FPiorski/XYGen/README.md

# XYgen
### 4 digit numerical diplay using an oscilloscope in XY mode without a microcontroller

#### Work in progress
Soldered everything up, found some bugs, still working on getting them all fixed
