FPiorski/XYGen/XYgen.pdf

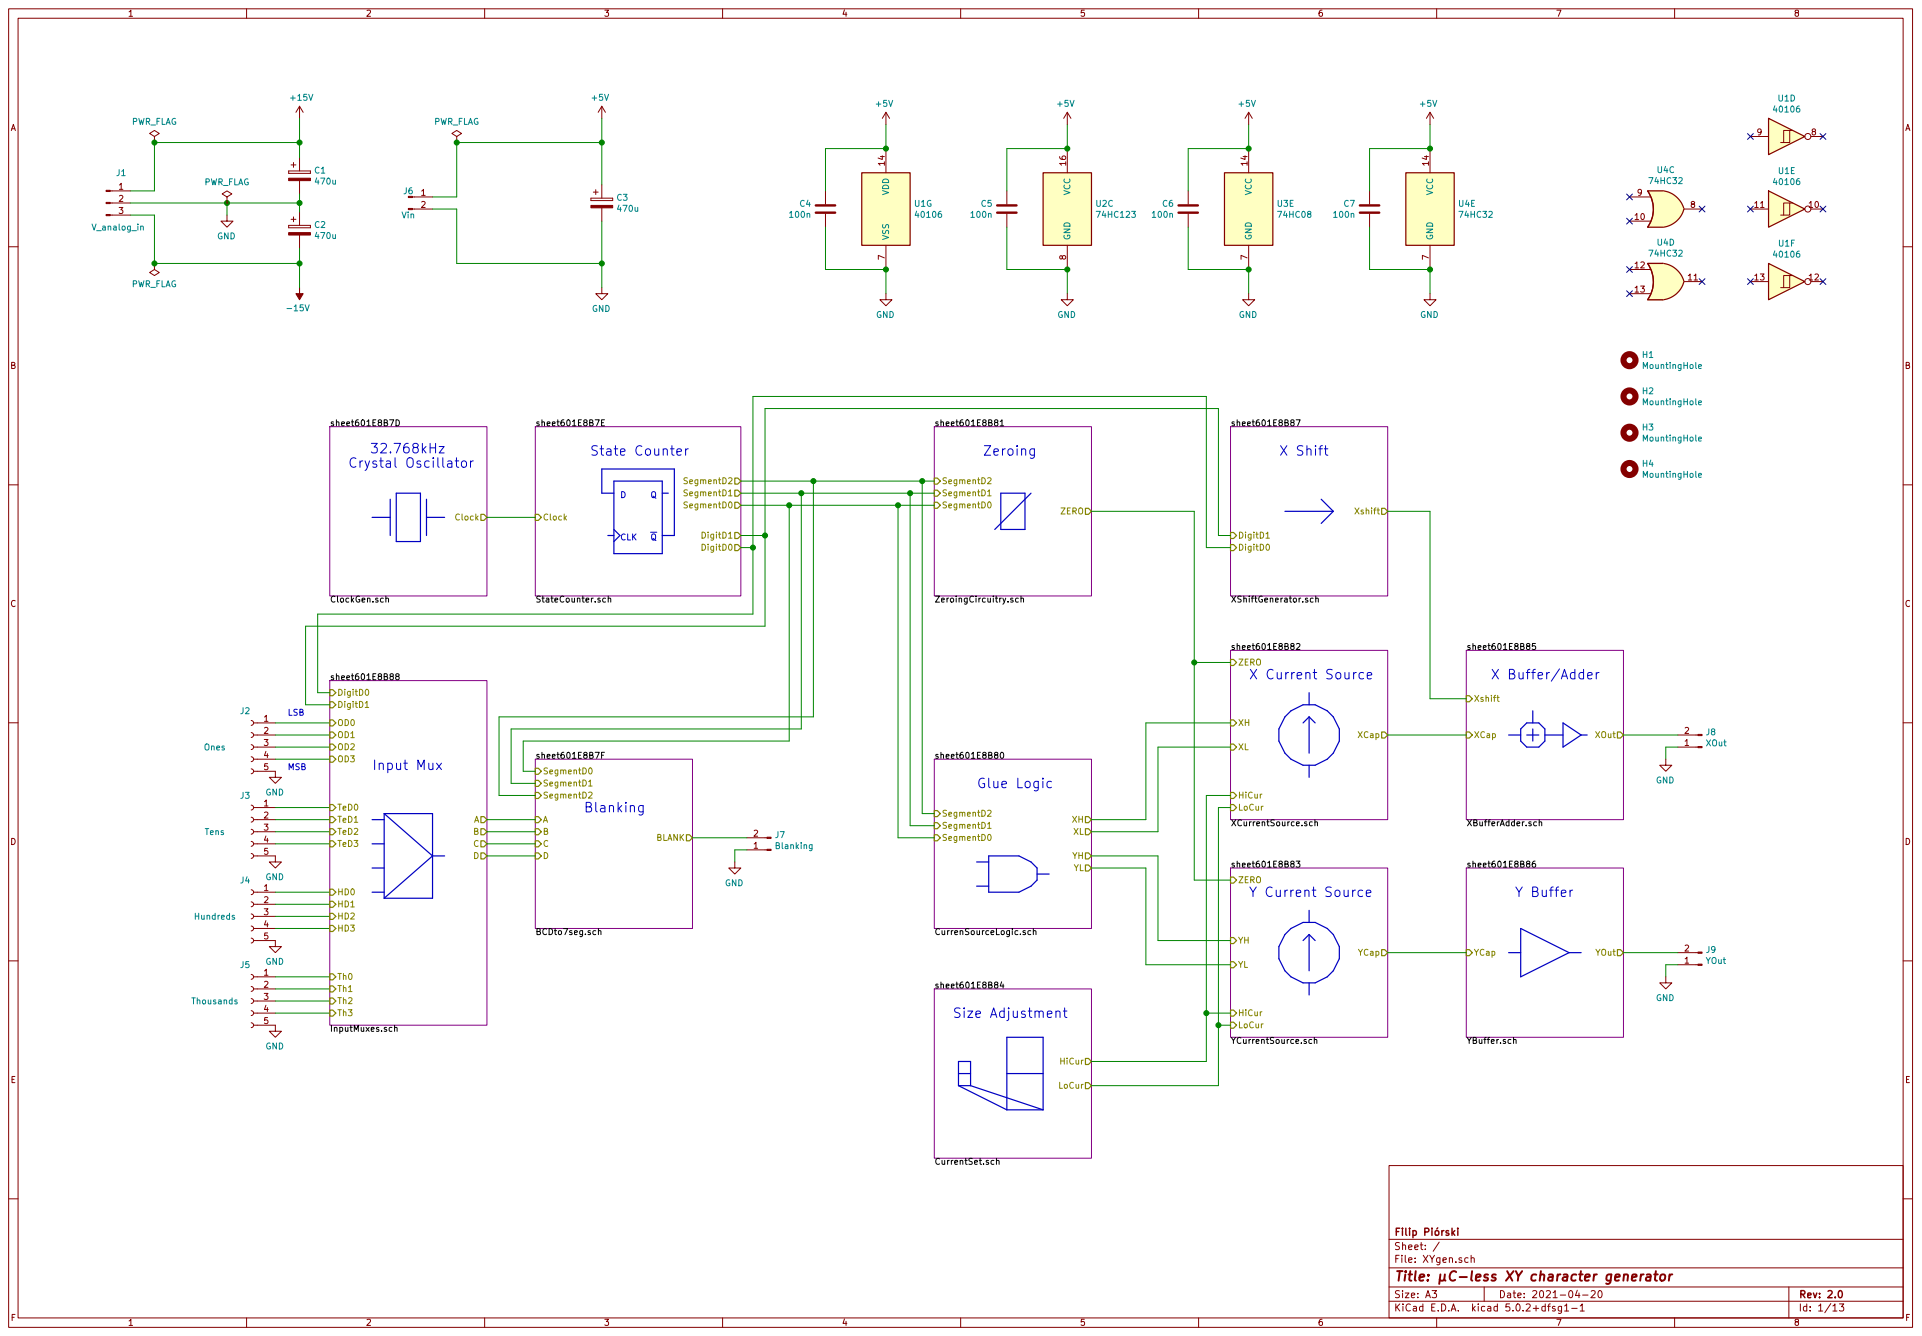
[picture p1: page 1]

File: XYgen.sch Sheet: / Filip Piórski

Id: 1/13 Title: µC-less XY character generator

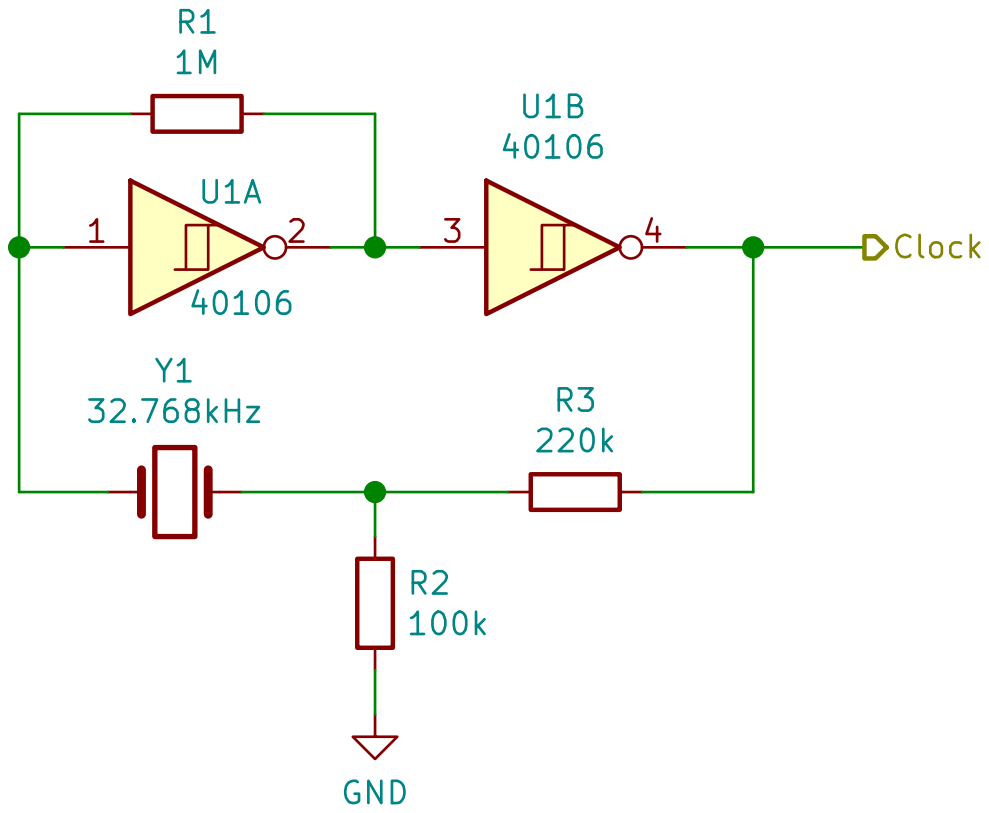
[picture p2: page 2]

Id: 2/13 Title: 32.786kHz Quartz Clock Generator File: ClockGen.sch Sheet: /sheet601E8B7D/ Filip Piórski

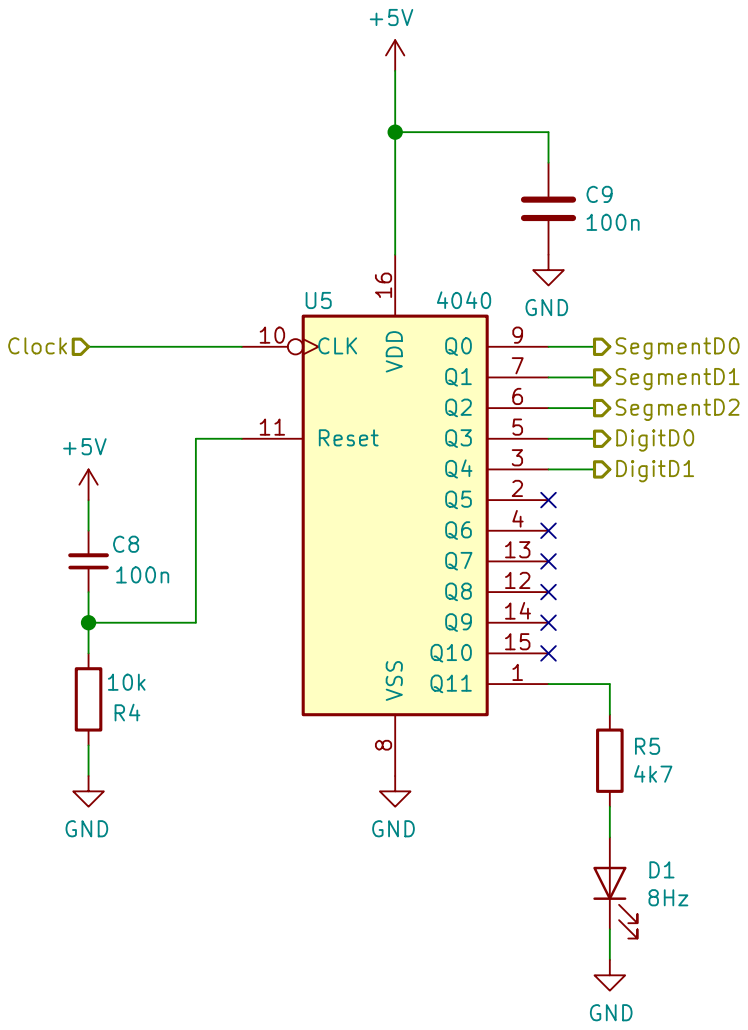
[picture p3: page 3]

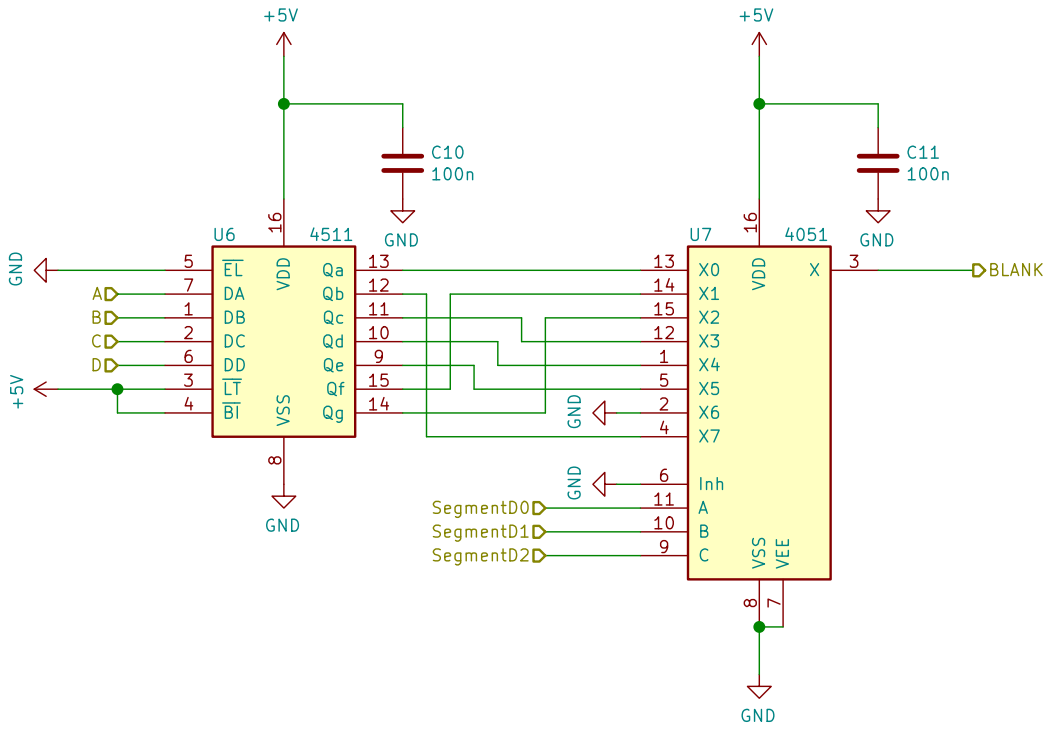
[picture p4: page 4]

Id: 4/13 Title: Blanking Signal Generator

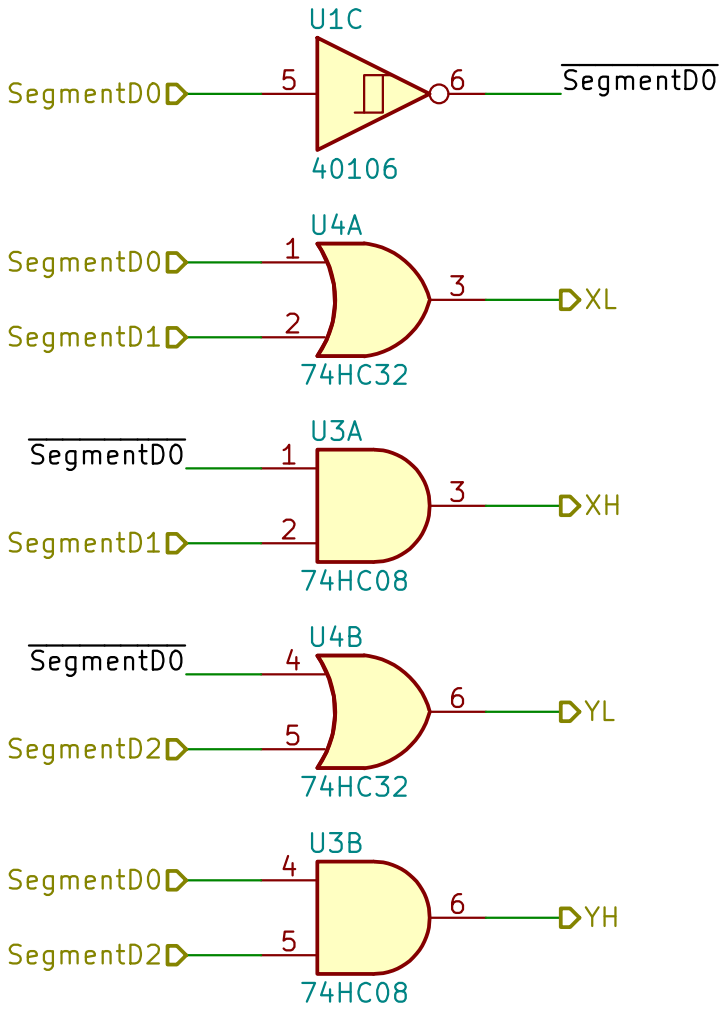
[picture p5: page 5]

File: CurrenSourceLogic.sch Sheet: /sheet601E8B80/ Filip Piórski

Id: 5/13 Title: Current Source Control Signal Generator

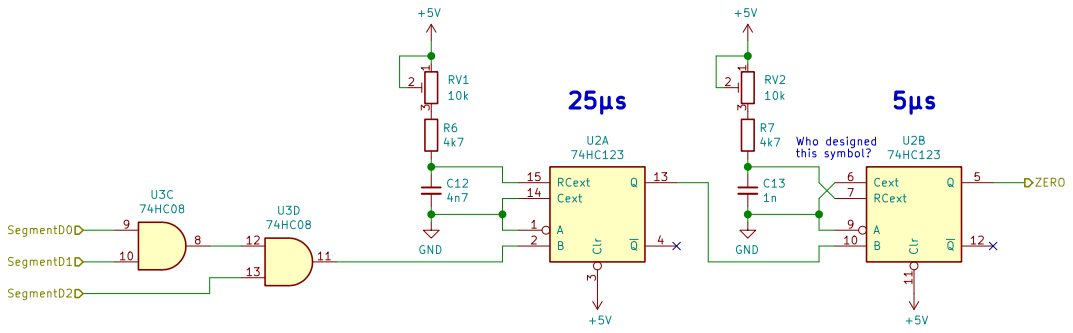
[picture p6: page 6]

File: ZeroingCircuitry.sch Sheet: /sheet601E8B81/ Filip Piórski A

Id: 6/13 Title: Zero Signal Generator

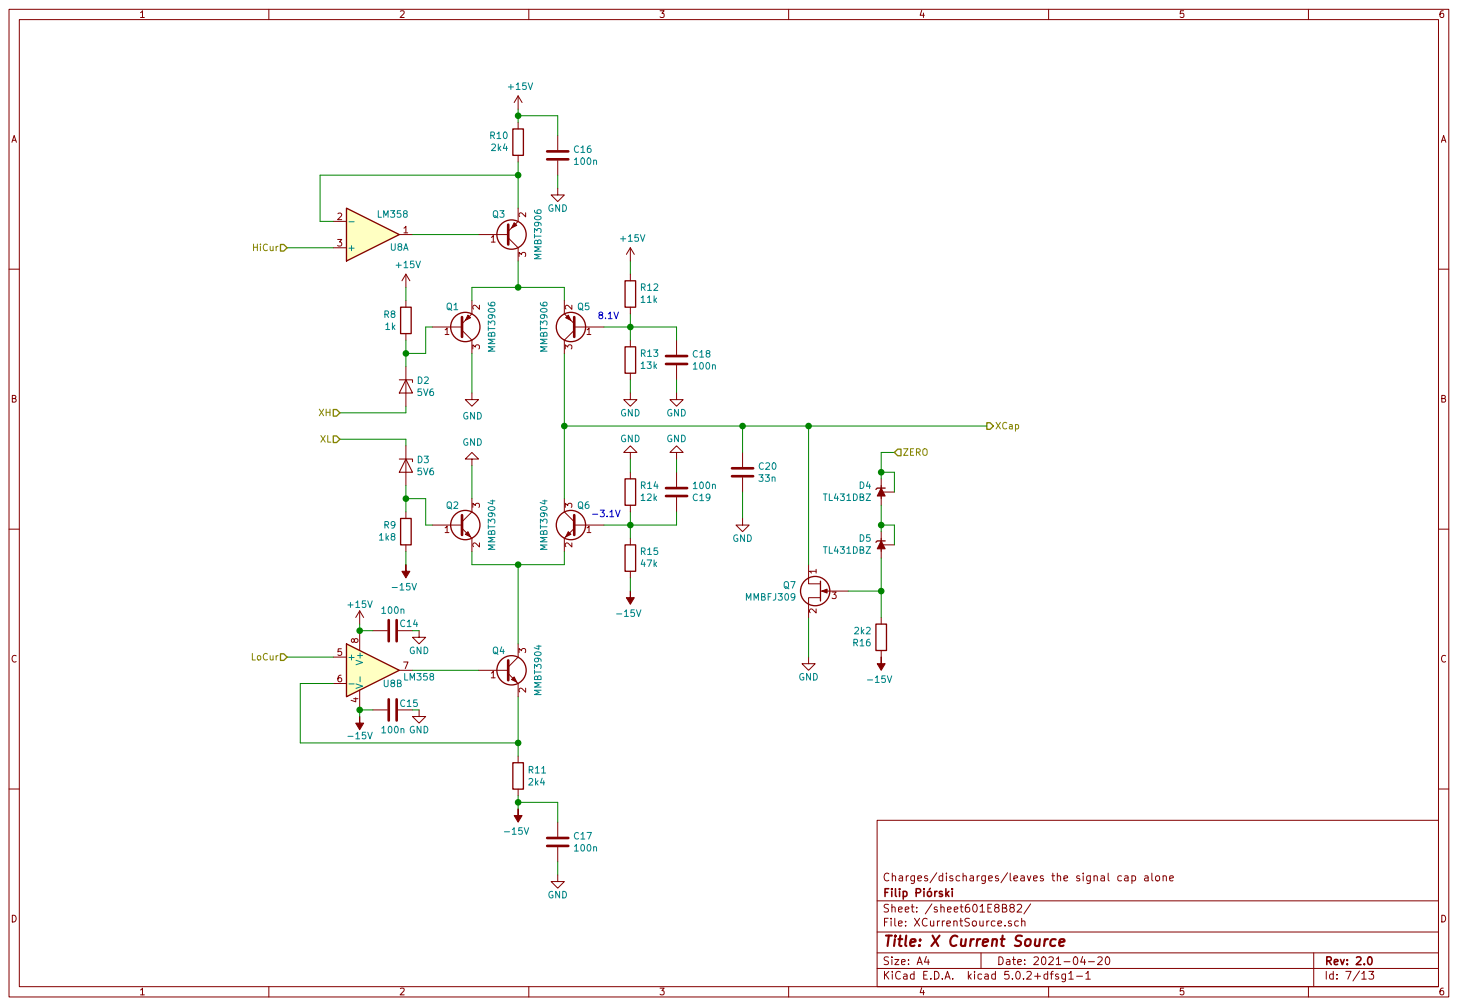
[picture p7: page 7]

File: XCurrentSource.sch Sheet: /sheet601E8B82/ Filip Piórski

Id: 7/13 Title: X Current Source

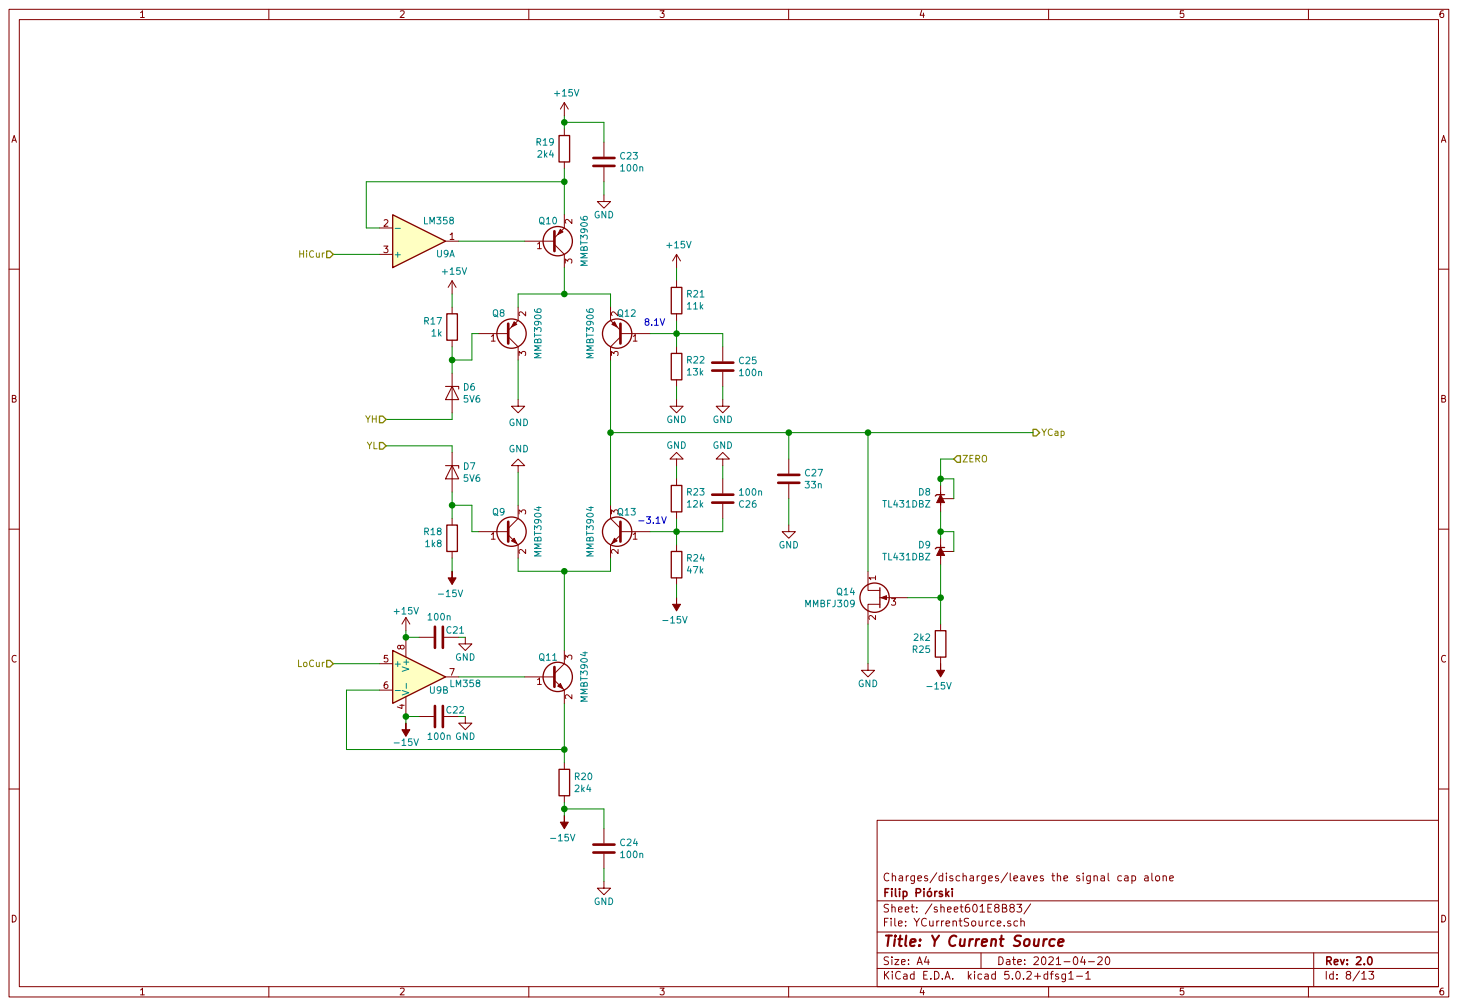
[picture p8: page 8]

File: YCurrentSource.sch Sheet: /sheet601E8B83/ Filip Piórski

Id: 8/13 Title: Y Current Source

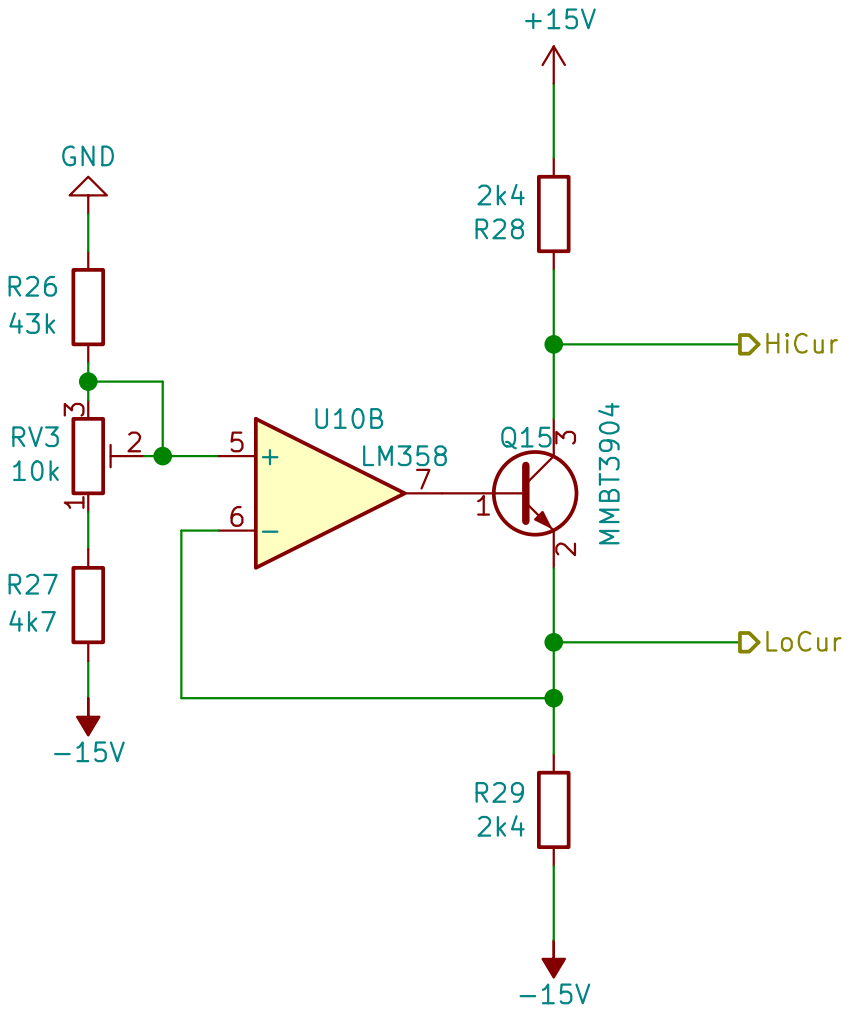
[picture p9: page 9]

Id: 9/13 Title: Size Adjustment File: CurrentSet.sch Sheet: /sheet601E8B84/ Filip Piórski 1

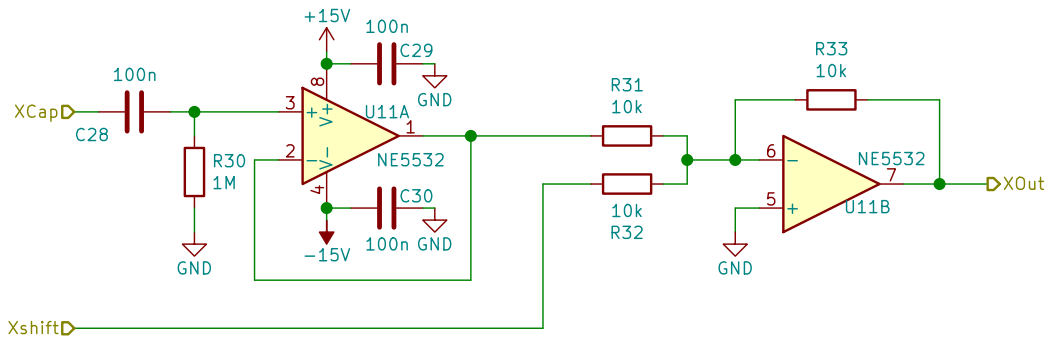
[picture p10: page 10]

Buffers the X signal and adds an offset (shift)
Id: 10/13 Title: X Buffer/Adder File: XBufferAdder.sch Sheet: /sheet601E8B85/ Filip Piórski

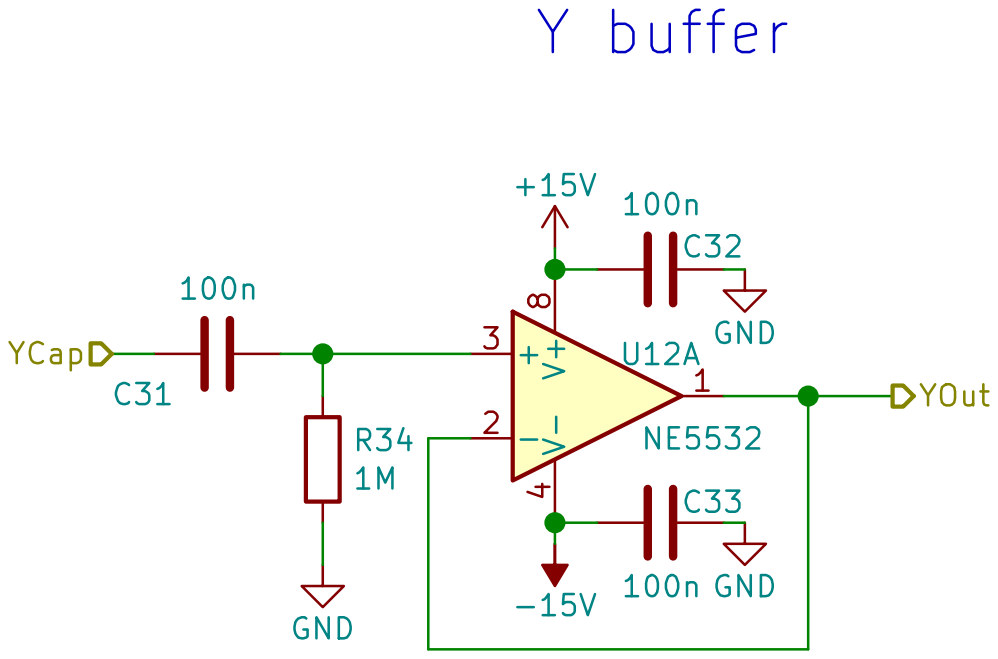
[picture p11: page 11]

Id: 11/13 Title: Y Buffer File: YBuffer.sch Sheet: /sheet601E8B86/ Filip Piórski

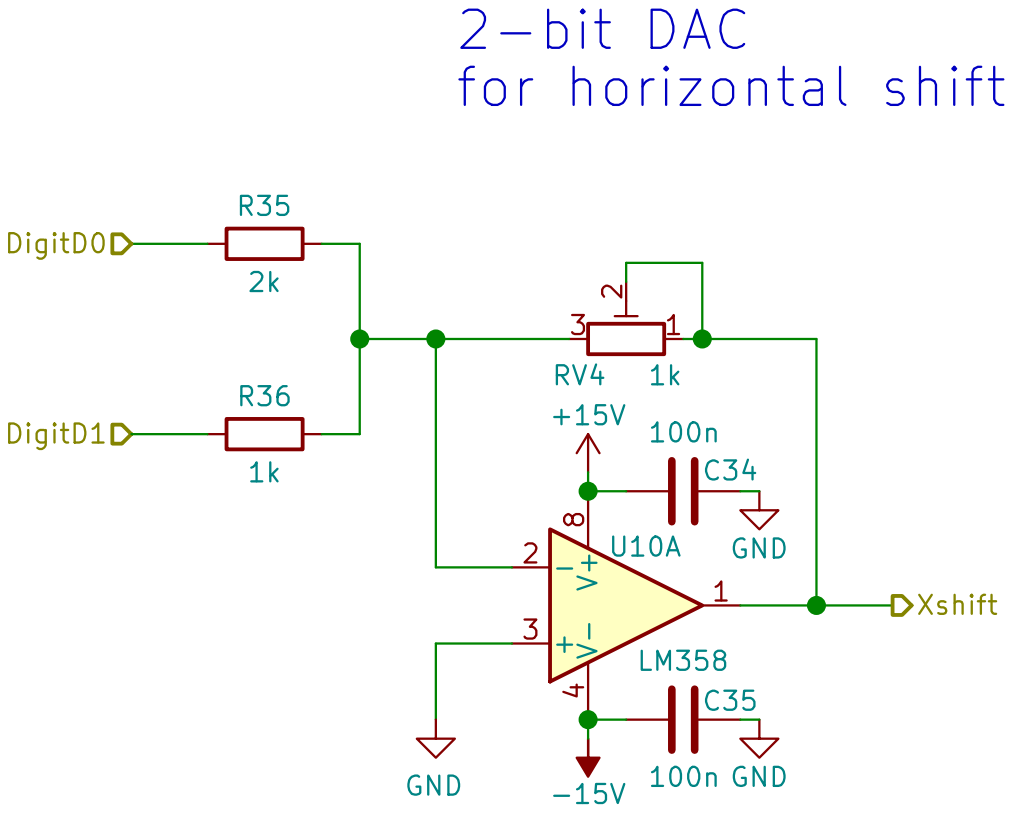
[picture p12: page 12]

Id: 12/13 Title: Horiznontal Shift Generator File: XShiftGenerator.sch Sheet: /sheet601E8B87/ Filip Piórski

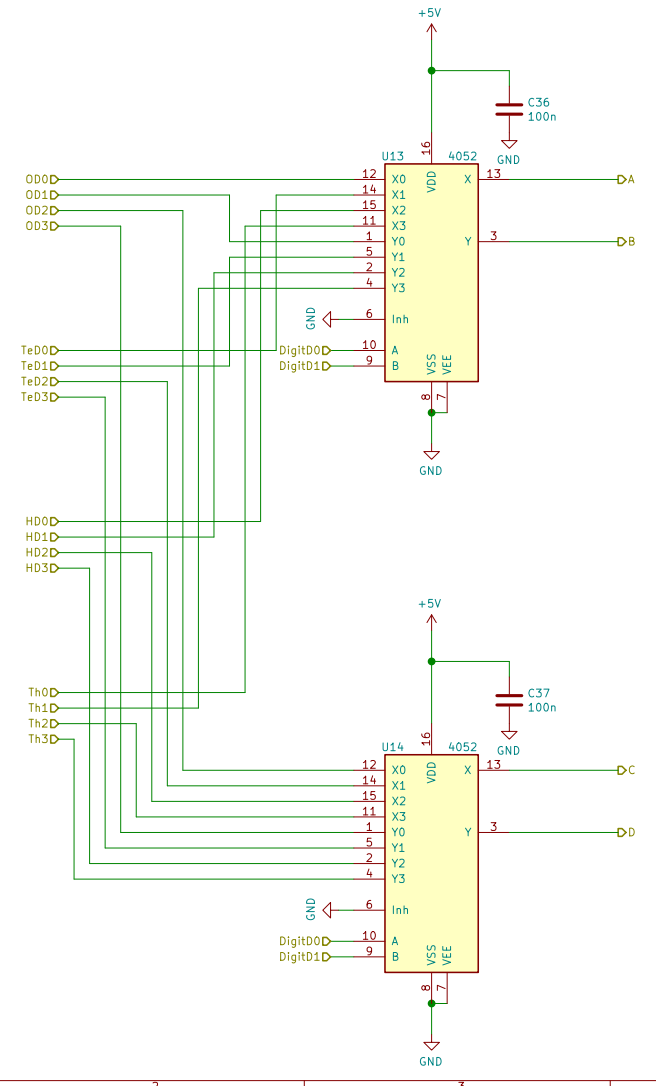
[picture p13: page 13]

Id: 13/13 Title: Input Multiplexer
