FPiorski/XYGen/XYgen.kicad_pcb

## KiCad design XYgen.kicad_pcb (2021-04-20)

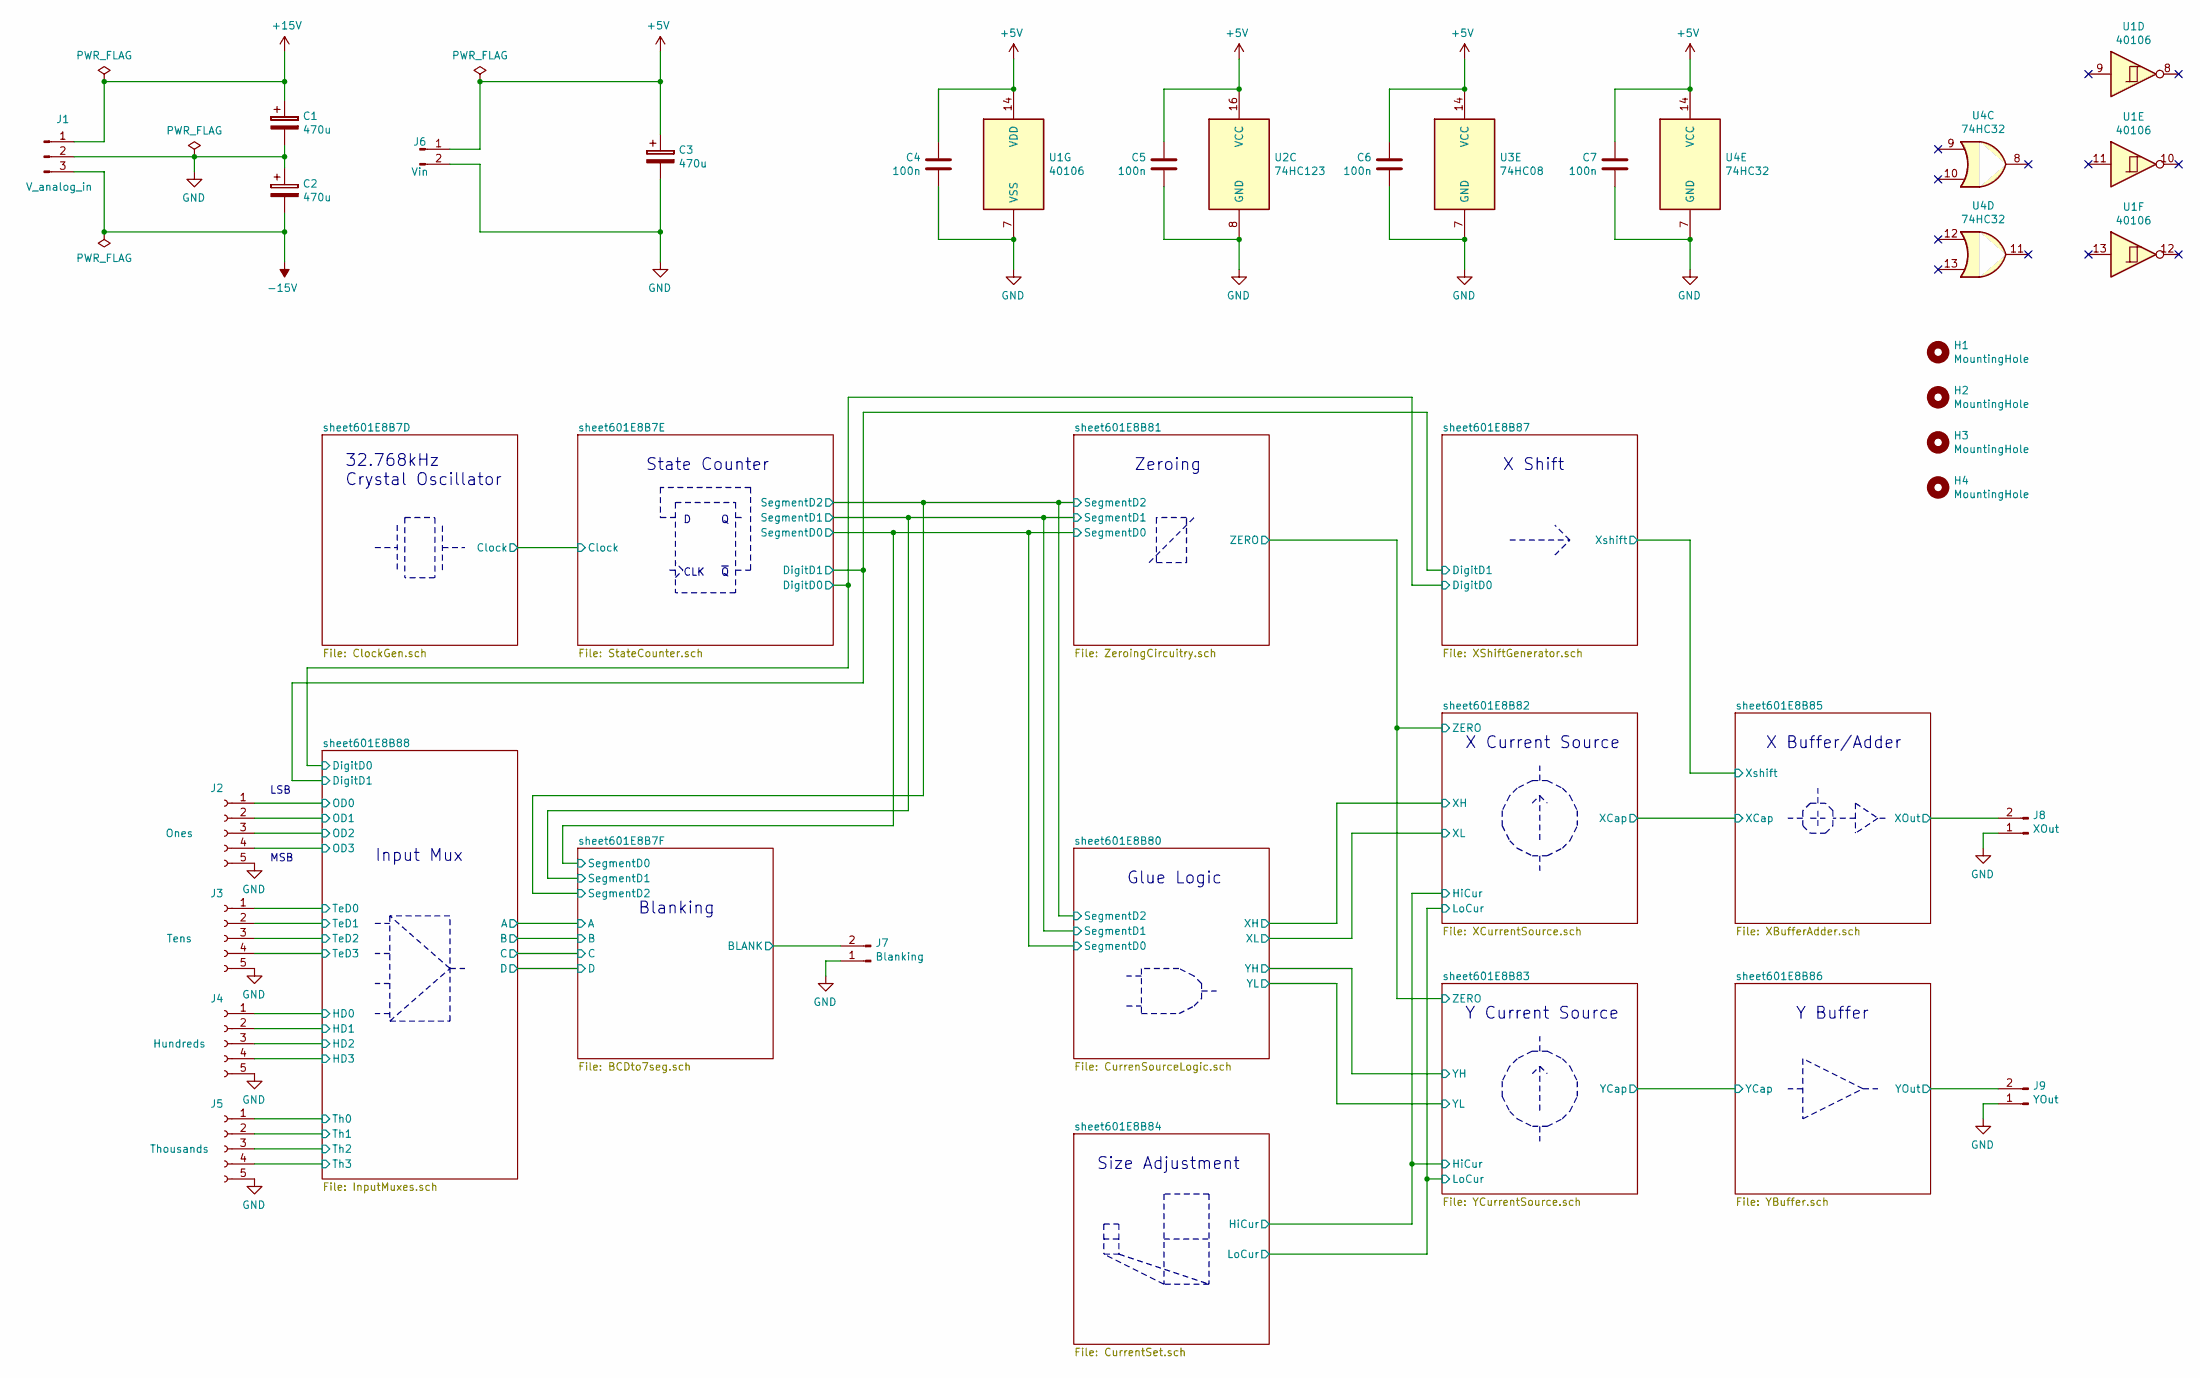
[picture p14: schematic XYgen.sch, µC-less XY character generator]

Parts:
C1, C2, C3: 470u; C_1206_3216Metric_Pad1.42x1.75mm_HandSolder
C4, C5, C6, C7: 100n; C_0805_2012Metric_Pad1.15x1.40mm_HandSolder
H1, H2, H3, H4: MountingHole; MountingHole_2.7mm_M2.5
J1: V_analog_in; Molex_KK-254_AE-6410-03A_1x03_P2.54mm_Vertical
J2: Ones; PinSocket_1x05_P2.54mm_Vertical
J3: Tens; PinSocket_1x05_P2.54mm_Vertical
J4: Hundreds; PinSocket_1x05_P2.54mm_Vertical
J5: Thousands; PinSocket_1x05_P2.54mm_Vertical
J6: Vin; Molex_KK-254_AE-6410-02A_1x02_P2.54mm_Vertical
J7: Blanking; PinHeader_1x02_P2.54mm_Vertical
J8: XOut; PinHeader_1x02_P2.54mm_Vertical
J9: YOut; PinHeader_1x02_P2.54mm_Vertical
U1: 40106; TSSOP-14_4.4x5mm_P0.65mm
U2: 74HC123; TSSOP-16_4.4x5mm_P0.65mm
U3: 74HC08; TSSOP-14_4.4x5mm_P0.65mm
U4: 74HC32; TSSOP-14_4.4x5mm_P0.65mm

Connections:
+5V: C3.1, C4.1, C5.1, C6.1, C7.1, J6.1, U1.14 (VDD), U2.16 (VCC), U3.14 (VCC), U4.14 (VCC); also elsewhere on the board
+15V: C1.1, J1.1; also elsewhere on the board
-15V: C2.2, J1.3; also elsewhere on the board
/sheet601E8B7F/BLANK: J7.2; also elsewhere on the board
/sheet601E8B85/XOut: J8.2; also elsewhere on the board
/sheet601E8B86/YOut: J9.2; also elsewhere on the board
/sheet601E8B88/HD0: J4.1; also elsewhere on the board
/sheet601E8B88/HD1: J4.2; also elsewhere on the board
/sheet601E8B88/HD2: J4.3; also elsewhere on the board
/sheet601E8B88/HD3: J4.4; also elsewhere on the board
/sheet601E8B88/OD0: J2.1; also elsewhere on the board
/sheet601E8B88/OD1: J2.2; also elsewhere on the board
/sheet601E8B88/OD2: J2.3; also elsewhere on the board
/sheet601E8B88/OD3: J2.4; also elsewhere on the board
/sheet601E8B88/TeD0: J3.1; also elsewhere on the board
/sheet601E8B88/TeD1: J3.2; also elsewhere on the board
/sheet601E8B88/TeD2: J3.3; also elsewhere on the board
/sheet601E8B88/TeD3: J3.4; also elsewhere on the board
/sheet601E8B88/Th0: J5.1; also elsewhere on the board
/sheet601E8B88/Th1: J5.2; also elsewhere on the board
/sheet601E8B88/Th2: J5.3; also elsewhere on the board
/sheet601E8B88/Th3: J5.4; also elsewhere on the board
GND: C1.2, C2.1, C3.2, C4.2, C5.2, C6.2, C7.2, J1.2, J2.5, J3.5, J4.5, J5.5, J6.2, J7.1, J8.1, J9.1, U1.7 (VSS), U2.8 (GND), U3.7 (GND), U4.7 (GND); also elsewhere on the board

Notes on the sheet:
32.768kHz Crystal Oscillator
CLK
State Counter
LSB
MSB
Zeroing
Input Mux
Blanking
X Shift
Glue Logic
Size Adjustment
X Current Source
Y Current Source
X Buffer/Adder
Y Buffer

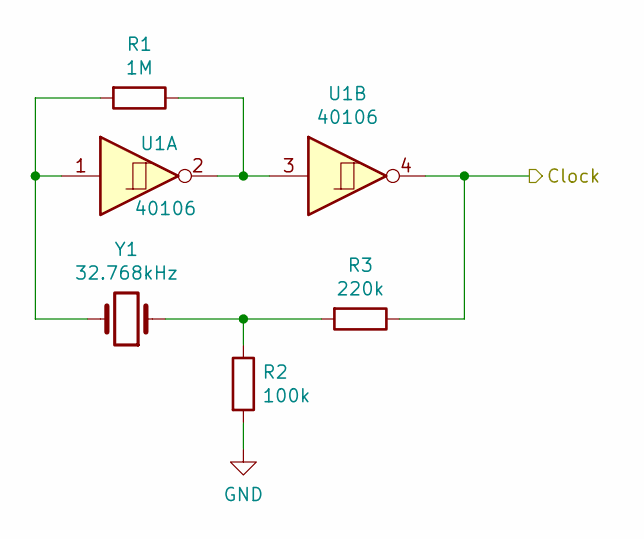
[picture p15: schematic ClockGen.sch, 32.786kHz Quartz Clock Generator]

Parts:
R1: 1M; R_0805_2012Metric_Pad1.15x1.40mm_HandSolder
R2: 100k; R_0805_2012Metric_Pad1.15x1.40mm_HandSolder
R3: 220k; R_0805_2012Metric_Pad1.15x1.40mm_HandSolder
U1: 40106; TSSOP-14_4.4x5mm_P0.65mm
Y1: 32.768kHz; Crystal_C26-LF_D2.1mm_L6.5mm_Vertical

Connections:
/sheet601E8B7D/Clock: R3.1, U1.4; also elsewhere on the board
GND: R2.2; also elsewhere on the board
unnamed: R1.1, U1.2, U1.3
unnamed: R1.2, U1.1, Y1.2
unnamed: R2.1, R3.2, Y1.1

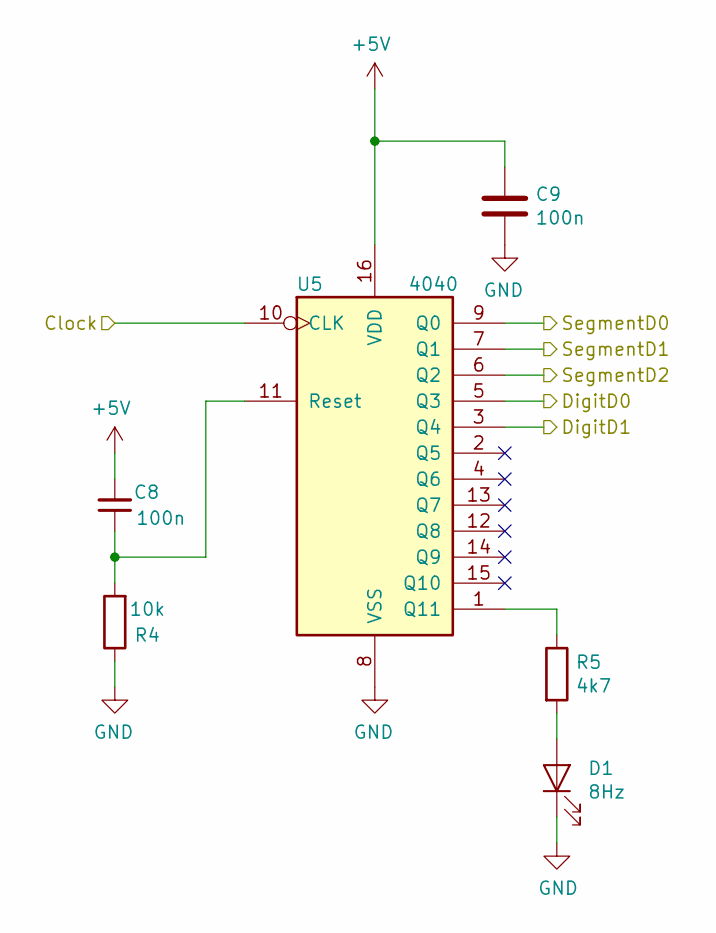
[picture p16: schematic StateCounter.sch, State Counter]

Parts:
C8, C9: 100n; C_0805_2012Metric_Pad1.15x1.40mm_HandSolder
D1: 8Hz; LED_0805_2012Metric_Pad1.15x1.40mm_HandSolder
R4: 10k; R_0805_2012Metric_Pad1.15x1.40mm_HandSolder
R5: 4k7; R_0805_2012Metric_Pad1.15x1.40mm_HandSolder
U5: 4040; TSSOP-16_4.4x5mm_P0.65mm

Connections:
+5V: C8.2, C9.1, U5.16 (VDD); also elsewhere on the board
/sheet601E8B7D/Clock: U5.10 (CLK); also elsewhere on the board
/sheet601E8B7E/DigitD0: U5.5 (Q3); also elsewhere on the board
/sheet601E8B7E/DigitD1: U5.3 (Q4); also elsewhere on the board
/sheet601E8B7E/SegmentD0: U5.9 (Q0); also elsewhere on the board
/sheet601E8B7E/SegmentD1: U5.7 (Q1); also elsewhere on the board
/sheet601E8B7E/SegmentD2: U5.6 (Q2); also elsewhere on the board
GND: C9.2, D1.1 (K), R4.1, U5.8 (VSS); also elsewhere on the board
unnamed: C8.1, R4.2, U5.11 (Reset)
unnamed: D1.2 (A), R5.2
unnamed: R5.1, U5.1 (Q11)

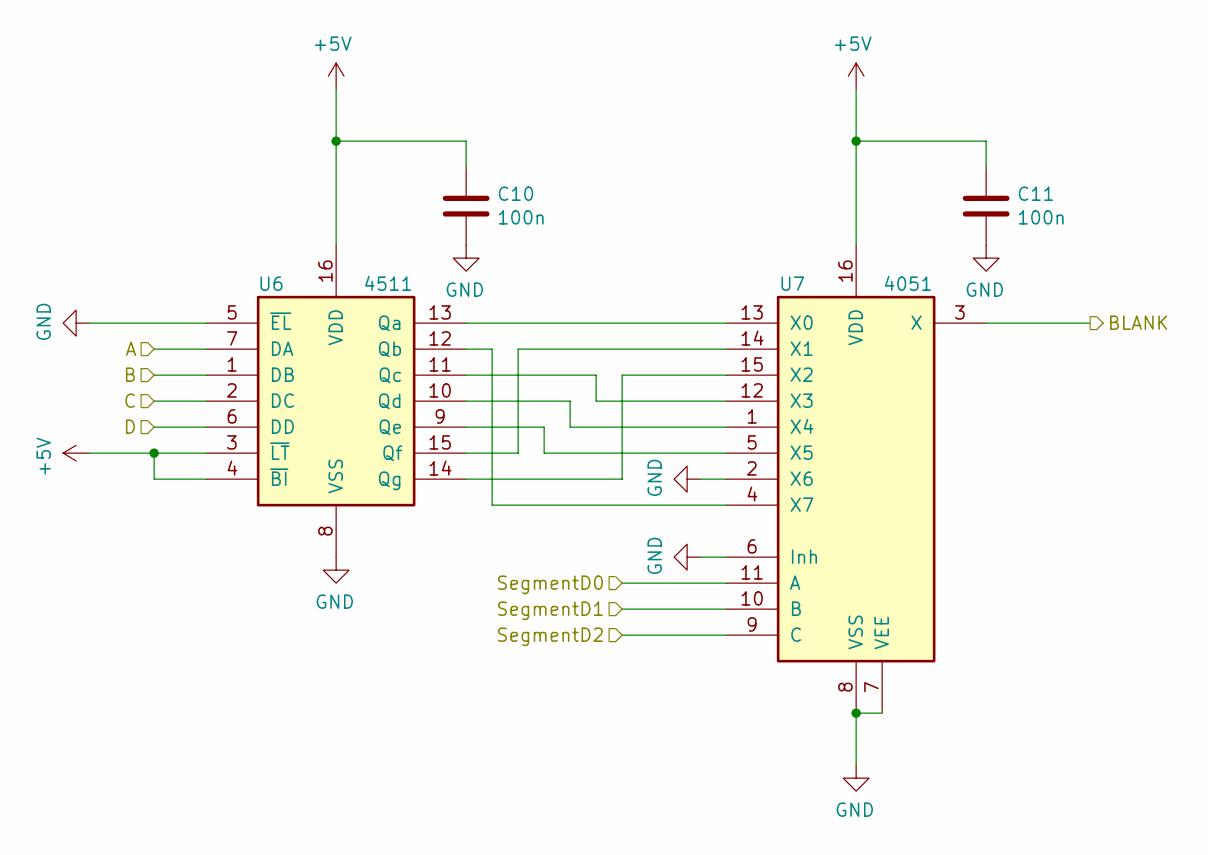
[picture p17: schematic BCDto7seg.sch, Blanking Signal Generator]

Parts:
C10, C11: 100n; C_0805_2012Metric_Pad1.15x1.40mm_HandSolder
U6: 4511; SOP-16_4.4x10.4mm_P1.27mm
U7: 4051; TSSOP-16_4.4x5mm_P0.65mm

Connections:
+5V: C10.1, C11.1, U6.3 (~LT), U6.4 (~BI), U6.16 (VDD), U7.16 (VDD); also elsewhere on the board
/sheet601E8B7E/SegmentD0: U7.11 (A); also elsewhere on the board
/sheet601E8B7E/SegmentD1: U7.10 (B); also elsewhere on the board
/sheet601E8B7E/SegmentD2: U7.9 (C); also elsewhere on the board
/sheet601E8B7F/A: U6.7 (DA); also elsewhere on the board
/sheet601E8B7F/B: U6.1 (DB); also elsewhere on the board
/sheet601E8B7F/BLANK: U7.3 (X); also elsewhere on the board
/sheet601E8B7F/C: U6.2 (DC); also elsewhere on the board
/sheet601E8B7F/D: U6.6 (DD); also elsewhere on the board
GND: C10.2, C11.2, U6.5 (~EL), U6.8 (VSS), U7.2 (X6), U7.6 (Inh), U7.7 (VEE), U7.8 (VSS); also elsewhere on the board
unnamed: U6.9 (Qe), U7.5 (X5)
unnamed: U6.10 (Qd), U7.1 (X4)
unnamed: U6.11 (Qc), U7.12 (X3)
unnamed: U6.12 (Qb), U7.4 (X7)
unnamed: U6.13 (Qa), U7.13 (X0)
unnamed: U6.14 (Qg), U7.15 (X2)
unnamed: U6.15 (Qf), U7.14 (X1)

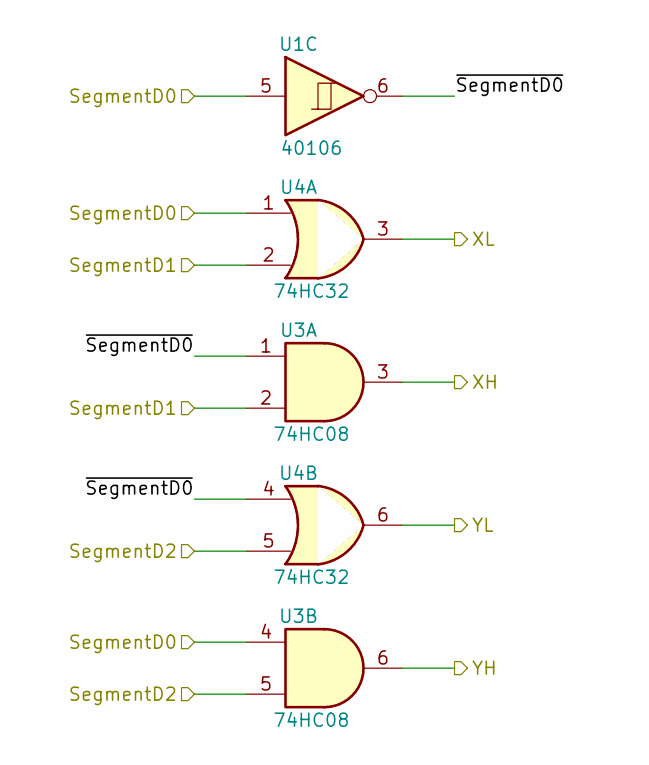
[picture p18: schematic CurrenSourceLogic.sch, Current Source Control Signal Generator]

Parts:
U1: 40106; TSSOP-14_4.4x5mm_P0.65mm
U3: 74HC08; TSSOP-14_4.4x5mm_P0.65mm
U4: 74HC32; TSSOP-14_4.4x5mm_P0.65mm

Connections:
/sheet601E8B7E/SegmentD0: U1.5, U3.4, U4.1; also elsewhere on the board
/sheet601E8B7E/SegmentD1: U3.2, U4.2; also elsewhere on the board
/sheet601E8B7E/SegmentD2: U3.5, U4.5; also elsewhere on the board
/sheet601E8B80/XH: U3.3; also elsewhere on the board
/sheet601E8B80/XL: U4.3; also elsewhere on the board
/sheet601E8B80/YH: U3.6; also elsewhere on the board
/sheet601E8B80/YL: U4.6; also elsewhere on the board
/sheet601E8B80/~SegmentD0: U1.6, U3.1, U4.4

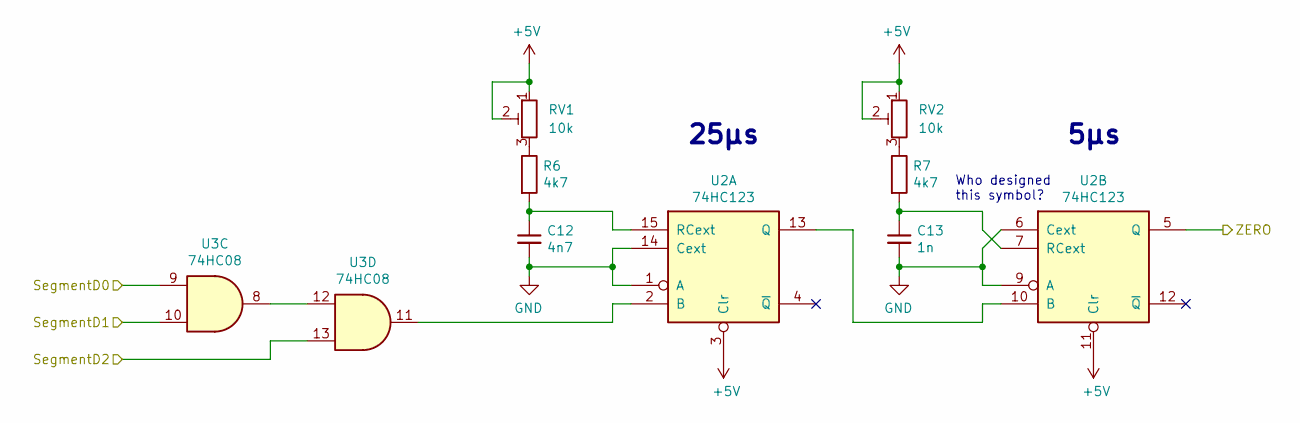
[picture p19: schematic ZeroingCircuitry.sch, Zero Signal Generator]

Parts:
C12: 4n7; C_0805_2012Metric_Pad1.15x1.40mm_HandSolder
C13: 1n; C_0805_2012Metric_Pad1.15x1.40mm_HandSolder
R6, R7: 4k7; R_0805_2012Metric_Pad1.15x1.40mm_HandSolder
RV1, RV2: 10k; Potentiometer_Bourns_3296W_Vertical
U2: 74HC123; TSSOP-16_4.4x5mm_P0.65mm
U3: 74HC08; TSSOP-14_4.4x5mm_P0.65mm

Connections:
+5V: RV1.1, RV1.2, RV2.1, RV2.2, U2.3 (Clr), U2.11 (Clr); also elsewhere on the board
/sheet601E8B7E/SegmentD0: U3.9; also elsewhere on the board
/sheet601E8B7E/SegmentD1: U3.10; also elsewhere on the board
/sheet601E8B7E/SegmentD2: U3.13; also elsewhere on the board
/sheet601E8B81/ZERO: U2.5 (Q); also elsewhere on the board
GND: C12.2, C13.2, U2.1 (A), U2.6 (Cext), U2.9 (A), U2.14 (Cext); also elsewhere on the board
unnamed: C12.1, R6.2, U2.15 (RCext)
unnamed: C13.1, R7.2, U2.7 (RCext)
unnamed: R6.1, RV1.3
unnamed: R7.1, RV2.3
unnamed: U2.2 (B), U3.11
unnamed: U2.10 (B), U2.13 (Q)
unnamed: U3.8, U3.12

Notes on the sheet:
25µs
5µs
Who designed this symbol?

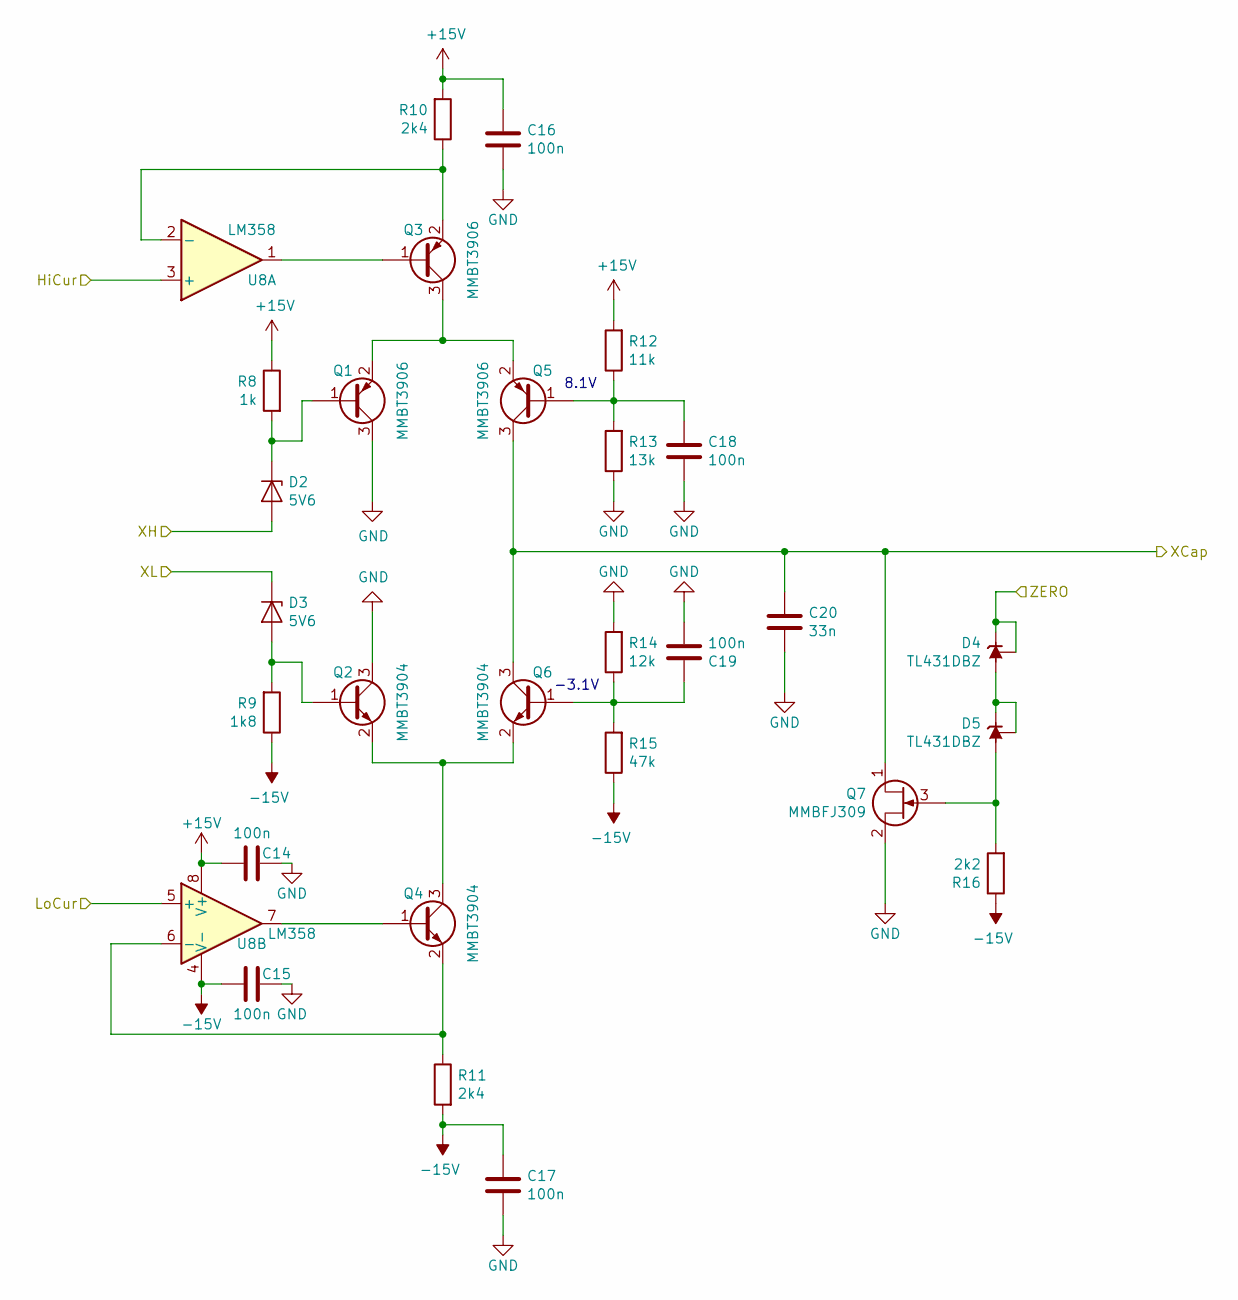
[picture p20: schematic XCurrentSource.sch, X Current Source]

Parts:
C14, C15, C16, C17, C18, C19: 100n; C_0805_2012Metric_Pad1.15x1.40mm_HandSolder
C20: 33n; C_0805_2012Metric_Pad1.15x1.40mm_HandSolder
D2, D3: 5V6; D_SOD-123
D4, D5: TL431DBZ; SOT-23
Q1, Q3, Q5: MMBT3906; SOT-23
Q2, Q4, Q6: MMBT3904; SOT-23
Q7: MMBFJ309; SOT-23
R8: 1k; R_0805_2012Metric_Pad1.15x1.40mm_HandSolder
R9: 1k8; R_0805_2012Metric_Pad1.15x1.40mm_HandSolder
R10, R11: 2k4; R_0805_2012Metric_Pad1.15x1.40mm_HandSolder
R12: 11k; R_0805_2012Metric_Pad1.15x1.40mm_HandSolder
R13: 13k; R_0805_2012Metric_Pad1.15x1.40mm_HandSolder
R14: 12k; R_0805_2012Metric_Pad1.15x1.40mm_HandSolder
R15: 47k; R_0805_2012Metric_Pad1.15x1.40mm_HandSolder
R16: 2k2; R_0805_2012Metric_Pad1.15x1.40mm_HandSolder
U8: LM358; SOIC-8_3.9x4.9mm_P1.27mm

Connections:
+15V: C14.1, C16.1, R8.1, R10.2, R12.2, U8.8 (V+); also elsewhere on the board
-15V: C15.1, C17.1, R9.1, R11.2, R15.1, R16.1, U8.4 (V-); also elsewhere on the board
/sheet601E8B80/XH: D2.2 (A); also elsewhere on the board
/sheet601E8B80/XL: D3.1 (K); also elsewhere on the board
/sheet601E8B81/ZERO: D4.1 (K), D4.2 (REF); also elsewhere on the board
/sheet601E8B82/HiCur: U8.3 (+); also elsewhere on the board
/sheet601E8B82/LoCur: U8.5 (+); also elsewhere on the board
/sheet601E8B82/XCap: C20.1, Q5.3 (C), Q6.3 (C), Q7.1 (D); also elsewhere on the board
GND: C14.2, C15.2, C16.2, C17.2, C18.2, C19.2, C20.2, Q1.3 (C), Q2.3 (C), Q7.2 (S), R13.1, R14.2; also elsewhere on the board
unnamed: C18.1, Q5.1 (B), R12.1, R13.2
unnamed: C19.1, Q6.1 (B), R14.1, R15.2
unnamed: D2.1 (K), Q1.1 (B), R8.2
unnamed: D3.2 (A), Q2.1 (B), R9.2
unnamed: D4.3 (A), D5.1 (K), D5.2 (REF)
unnamed: D5.3 (A), Q7.3 (G), R16.2
unnamed: Q1.2 (E), Q3.3 (C), Q5.2 (E)
unnamed: Q2.2 (E), Q4.3 (C), Q6.2 (E)
unnamed: Q3.1 (B), U8.1
unnamed: Q3.2 (E), R10.1, U8.2 (-)
unnamed: Q4.1 (B), U8.7
unnamed: Q4.2 (E), R11.1, U8.6 (-)

Notes on the sheet:
8.1V
-3.1V

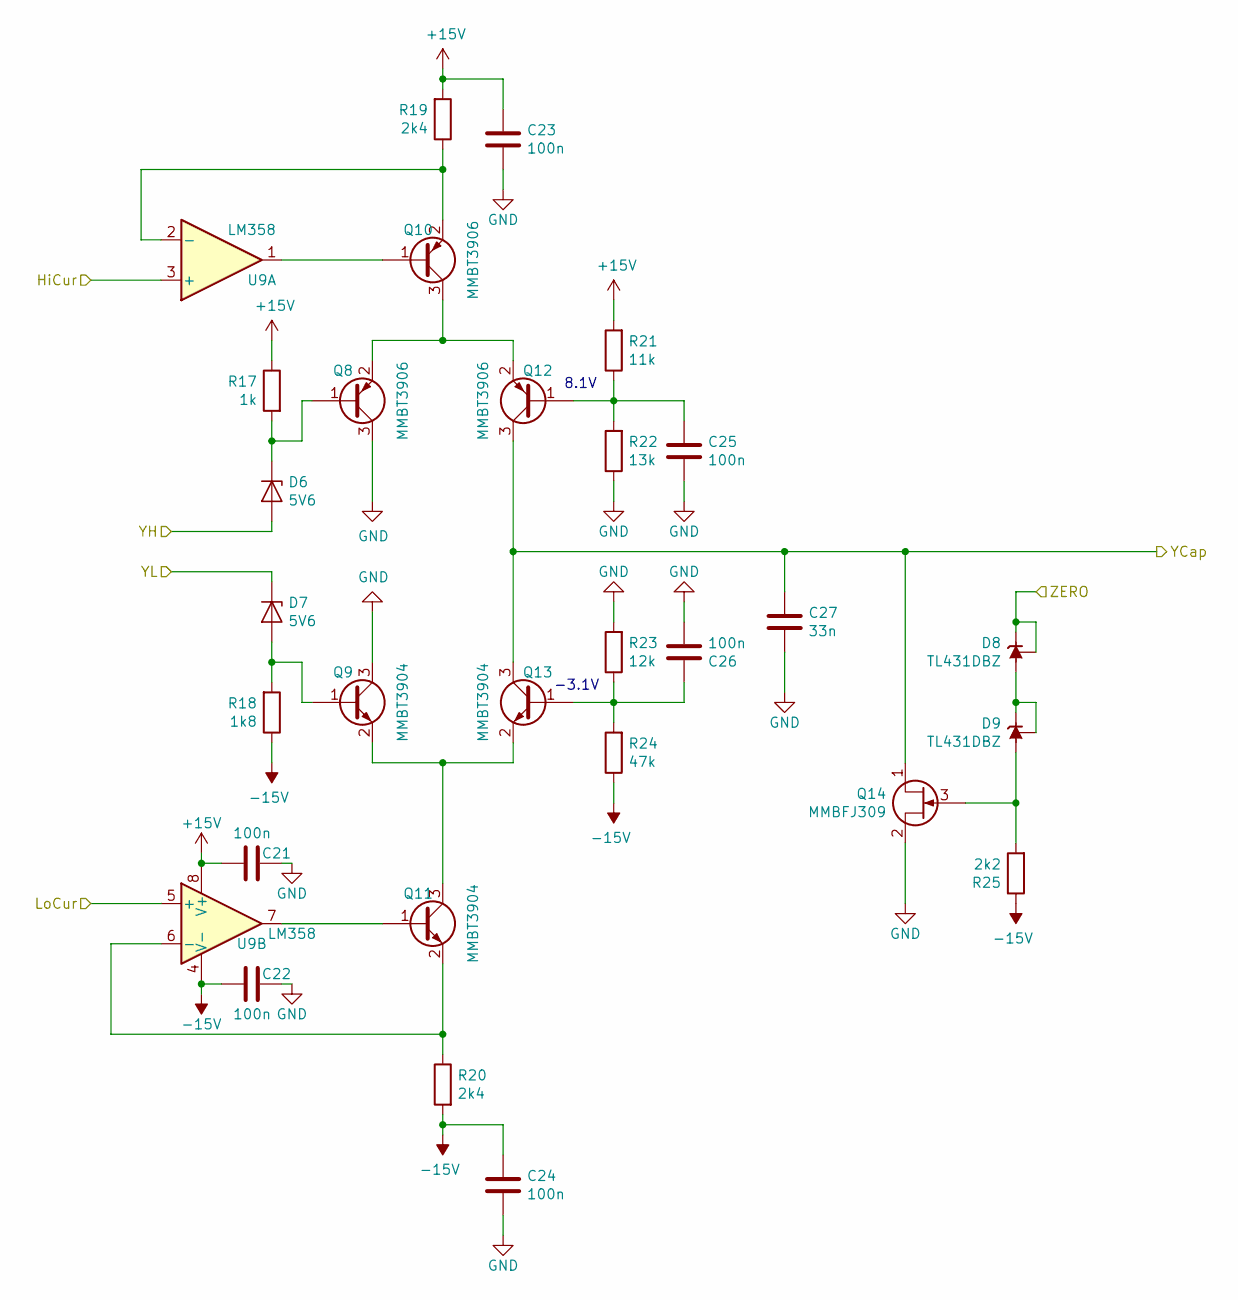
[picture p21: schematic YCurrentSource.sch, Y Current Source]

Parts:
C21, C22, C23, C24, C25, C26: 100n; C_0805_2012Metric_Pad1.15x1.40mm_HandSolder
C27: 33n; C_0805_2012Metric_Pad1.15x1.40mm_HandSolder
D6, D7: 5V6; D_SOD-123
D8, D9: TL431DBZ; SOT-23
Q8, Q10, Q12: MMBT3906; SOT-23
Q9, Q11, Q13: MMBT3904; SOT-23
Q14: MMBFJ309; SOT-23
R17: 1k; R_0805_2012Metric_Pad1.15x1.40mm_HandSolder
R18: 1k8; R_0805_2012Metric_Pad1.15x1.40mm_HandSolder
R19, R20: 2k4; R_0805_2012Metric_Pad1.15x1.40mm_HandSolder
R21: 11k; R_0805_2012Metric_Pad1.15x1.40mm_HandSolder
R22: 13k; R_0805_2012Metric_Pad1.15x1.40mm_HandSolder
R23: 12k; R_0805_2012Metric_Pad1.15x1.40mm_HandSolder
R24: 47k; R_0805_2012Metric_Pad1.15x1.40mm_HandSolder
R25: 2k2; R_0805_2012Metric_Pad1.15x1.40mm_HandSolder
U9: LM358; SOIC-8_3.9x4.9mm_P1.27mm

Connections:
+15V: C21.1, C23.1, R17.1, R19.2, R21.2, U9.8 (V+); also elsewhere on the board
-15V: C22.1, C24.1, R18.1, R20.2, R24.1, R25.1, U9.4 (V-); also elsewhere on the board
/sheet601E8B80/YH: D6.2 (A); also elsewhere on the board
/sheet601E8B80/YL: D7.1 (K); also elsewhere on the board
/sheet601E8B81/ZERO: D8.1 (K), D8.2 (REF); also elsewhere on the board
/sheet601E8B82/HiCur: U9.3 (+); also elsewhere on the board
/sheet601E8B82/LoCur: U9.5 (+); also elsewhere on the board
/sheet601E8B83/YCap: C27.1, Q12.3 (C), Q13.3 (C), Q14.1 (D); also elsewhere on the board
GND: C21.2, C22.2, C23.2, C24.2, C25.2, C26.2, C27.2, Q8.3 (C), Q9.3 (C), Q14.2 (S), R22.1, R23.2; also elsewhere on the board
unnamed: C25.1, Q12.1 (B), R21.1, R22.2
unnamed: C26.1, Q13.1 (B), R23.1, R24.2
unnamed: D6.1 (K), Q8.1 (B), R17.2
unnamed: D7.2 (A), Q9.1 (B), R18.2
unnamed: D8.3 (A), D9.1 (K), D9.2 (REF)
unnamed: D9.3 (A), Q14.3 (G), R25.2
unnamed: Q10.1 (B), U9.1
unnamed: Q10.2 (E), R19.1, U9.2 (-)
unnamed: Q8.2 (E), Q10.3 (C), Q12.2 (E)
unnamed: Q11.1 (B), U9.7
unnamed: Q11.2 (E), R20.1, U9.6 (-)
unnamed: Q9.2 (E), Q11.3 (C), Q13.2 (E)

Notes on the sheet:
8.1V
-3.1V

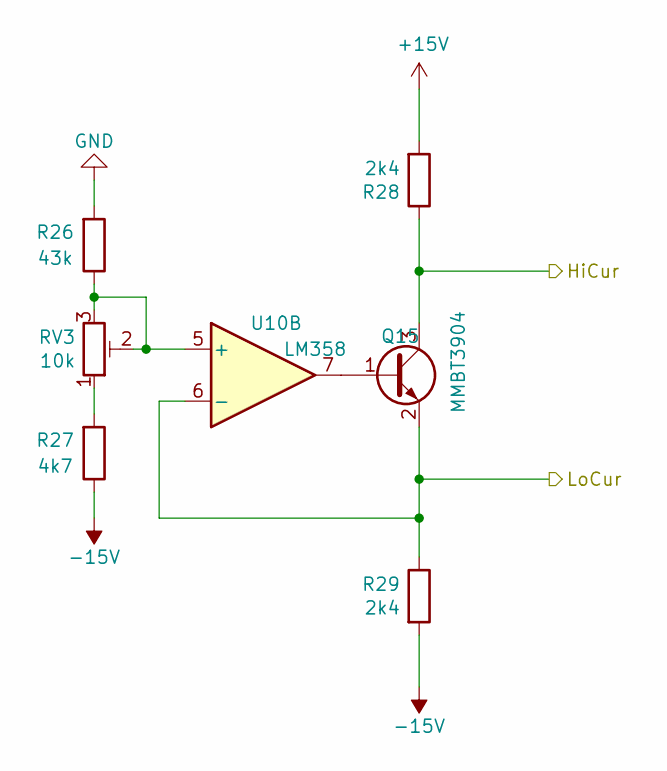
[picture p22: schematic CurrentSet.sch, Size Adjustment]

Parts:
Q15: MMBT3904; SOT-23
R26: 43k; R_0805_2012Metric_Pad1.15x1.40mm_HandSolder
R27: 4k7; R_0805_2012Metric_Pad1.15x1.40mm_HandSolder
R28, R29: 2k4; R_0805_2012Metric_Pad1.15x1.40mm_HandSolder
RV3: 10k; Potentiometer_Bourns_3296W_Vertical
U10: LM358; SOIC-8_3.9x4.9mm_P1.27mm

Connections:
+15V: R28.2; also elsewhere on the board
-15V: R27.1, R29.2; also elsewhere on the board
/sheet601E8B82/HiCur: Q15.3 (C), R28.1; also elsewhere on the board
/sheet601E8B82/LoCur: Q15.2 (E), R29.1, U10.6 (-); also elsewhere on the board
GND: R26.2; also elsewhere on the board
unnamed: Q15.1 (B), U10.7
unnamed: R26.1, RV3.2, RV3.3, U10.5 (+)
unnamed: R27.2, RV3.1

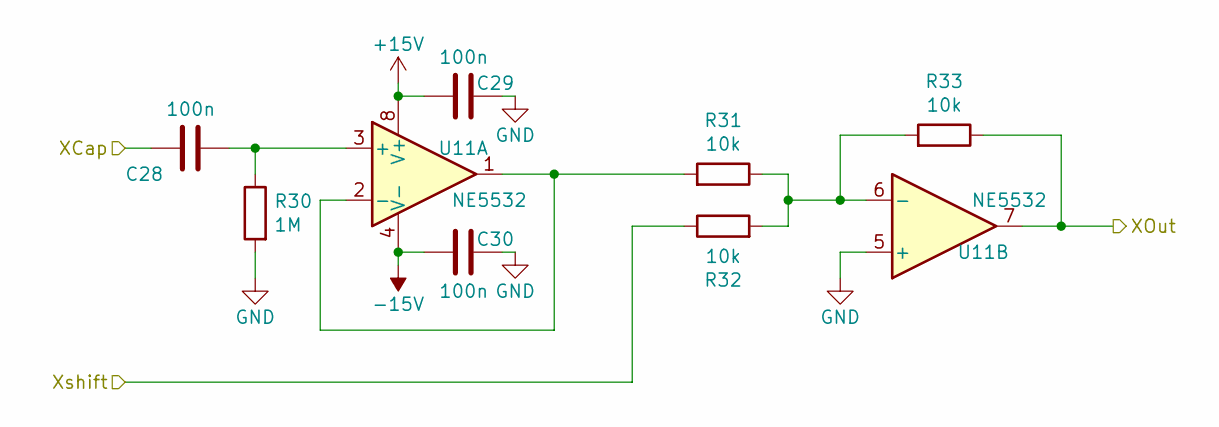
[picture p23: schematic XBufferAdder.sch, X Buffer/Adder]

Parts:
C28, C29, C30: 100n; C_0805_2012Metric_Pad1.15x1.40mm_HandSolder
R30: 1M; R_0805_2012Metric_Pad1.15x1.40mm_HandSolder
R31, R32, R33: 10k; R_0805_2012Metric_Pad1.15x1.40mm_HandSolder
U11: NE5532; SOIC-8_3.9x4.9mm_P1.27mm

Connections:
+15V: C29.1, U11.8 (V+); also elsewhere on the board
-15V: C30.1, U11.4 (V-); also elsewhere on the board
/sheet601E8B82/XCap: C28.1; also elsewhere on the board
/sheet601E8B85/XOut: R33.1, U11.7; also elsewhere on the board
/sheet601E8B85/Xshift: R32.1; also elsewhere on the board
GND: C29.2, C30.2, R30.2, U11.5 (+); also elsewhere on the board
unnamed: C28.2, R30.1, U11.3 (+)
unnamed: R31.1, R32.2, R33.2, U11.6 (-)
unnamed: R31.2, U11.1, U11.2 (-)

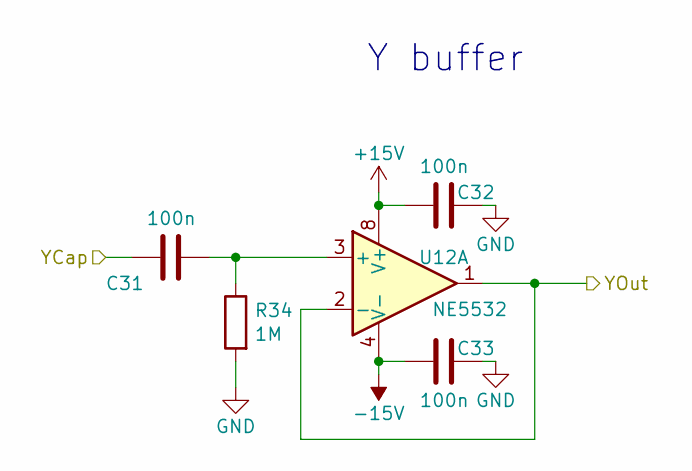
[picture p24: schematic YBuffer.sch, Y Buffer]

Parts:
C31, C32, C33: 100n; C_0805_2012Metric_Pad1.15x1.40mm_HandSolder
R34: 1M; R_0805_2012Metric_Pad1.15x1.40mm_HandSolder
U12: NE5532; SOIC-8_3.9x4.9mm_P1.27mm

Connections:
+15V: C32.1, U12.8 (V+); also elsewhere on the board
-15V: C33.1, U12.4 (V-); also elsewhere on the board
/sheet601E8B83/YCap: C31.1; also elsewhere on the board
/sheet601E8B86/YOut: U12.1, U12.2 (-); also elsewhere on the board
GND: C32.2, C33.2, R34.2; also elsewhere on the board
unnamed: C31.2, R34.1, U12.3 (+)

Notes on the sheet:
Y buffer

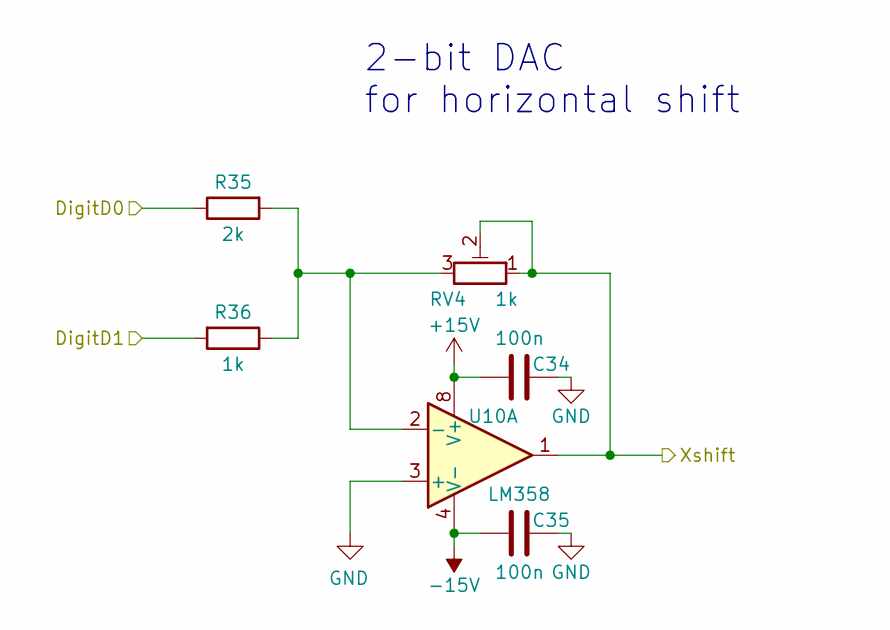
[picture p25: schematic XShiftGenerator.sch, Horiznontal Shift Generator]

Parts:
C34, C35: 100n; C_0805_2012Metric_Pad1.15x1.40mm_HandSolder
R35: 2k; R_0805_2012Metric_Pad1.15x1.40mm_HandSolder
R36: 1k; R_0805_2012Metric_Pad1.15x1.40mm_HandSolder
RV4: 1k; Potentiometer_Bourns_3296W_Vertical
U10: LM358; SOIC-8_3.9x4.9mm_P1.27mm

Connections:
+15V: C34.1, U10.8 (V+); also elsewhere on the board
-15V: C35.1, U10.4 (V-); also elsewhere on the board
/sheet601E8B7E/DigitD0: R35.1; also elsewhere on the board
/sheet601E8B7E/DigitD1: R36.2; also elsewhere on the board
/sheet601E8B85/Xshift: RV4.1, RV4.2, U10.1; also elsewhere on the board
GND: C34.2, C35.2, U10.3 (+); also elsewhere on the board
unnamed: R35.2, R36.1, RV4.3, U10.2 (-)

Notes on the sheet:
2-bit DAC for horizontal shift

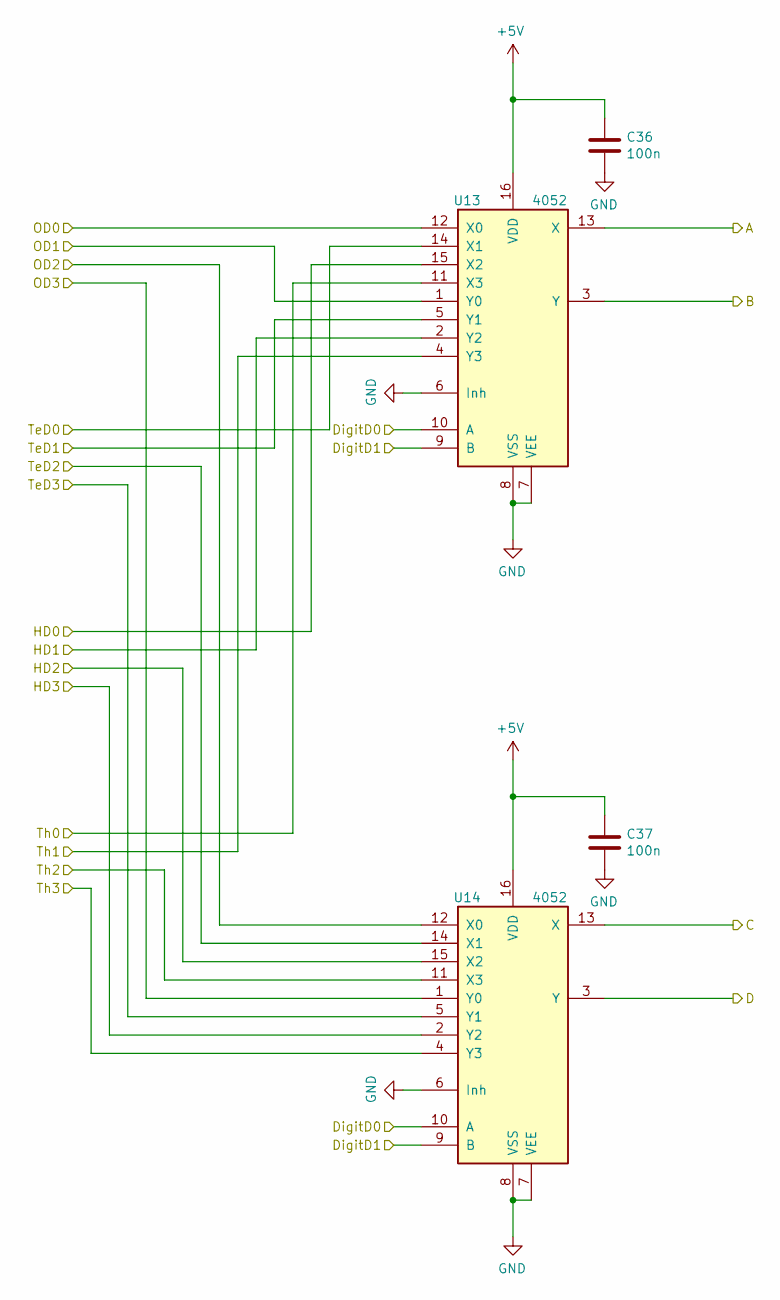
[picture p26: schematic InputMuxes.sch, Input Multiplexer]

Parts:
C36, C37: 100n; C_0805_2012Metric_Pad1.15x1.40mm_HandSolder
U13, U14: 4052; TSSOP-16_4.4x5mm_P0.65mm

Connections:
+5V: C36.1, C37.1, U13.16 (VDD), U14.16 (VDD); also elsewhere on the board
/sheet601E8B7E/DigitD0: U13.10 (A), U14.10 (A); also elsewhere on the board
/sheet601E8B7E/DigitD1: U13.9 (B), U14.9 (B); also elsewhere on the board
/sheet601E8B7F/A: U13.13 (X); also elsewhere on the board
/sheet601E8B7F/B: U13.3 (Y); also elsewhere on the board
/sheet601E8B7F/C: U14.13 (X); also elsewhere on the board
/sheet601E8B7F/D: U14.3 (Y); also elsewhere on the board
/sheet601E8B88/HD0: U13.15 (X2); also elsewhere on the board
/sheet601E8B88/HD1: U13.2 (Y2); also elsewhere on the board
/sheet601E8B88/HD2: U14.15 (X2); also elsewhere on the board
/sheet601E8B88/HD3: U14.2 (Y2); also elsewhere on the board
/sheet601E8B88/OD0: U13.12 (X0); also elsewhere on the board
/sheet601E8B88/OD1: U13.1 (Y0); also elsewhere on the board
/sheet601E8B88/OD2: U14.12 (X0); also elsewhere on the board
/sheet601E8B88/OD3: U14.1 (Y0); also elsewhere on the board
/sheet601E8B88/TeD0: U13.14 (X1); also elsewhere on the board
/sheet601E8B88/TeD1: U13.5 (Y1); also elsewhere on the board
/sheet601E8B88/TeD2: U14.14 (X1); also elsewhere on the board
/sheet601E8B88/TeD3: U14.5 (Y1); also elsewhere on the board
/sheet601E8B88/Th0: U13.11 (X3); also elsewhere on the board
/sheet601E8B88/Th1: U13.4 (Y3); also elsewhere on the board
/sheet601E8B88/Th2: U14.11 (X3); also elsewhere on the board
/sheet601E8B88/Th3: U14.4 (Y3); also elsewhere on the board
GND: C36.2, C37.2, U13.6 (Inh), U13.7 (VEE), U13.8 (VSS), U14.6 (Inh), U14.7 (VEE), U14.8 (VSS); also elsewhere on the board
