FPiorski/XYGen/XYgen.kicad_pcb

## KiCad design XYgen.kicad_pcb (continued)

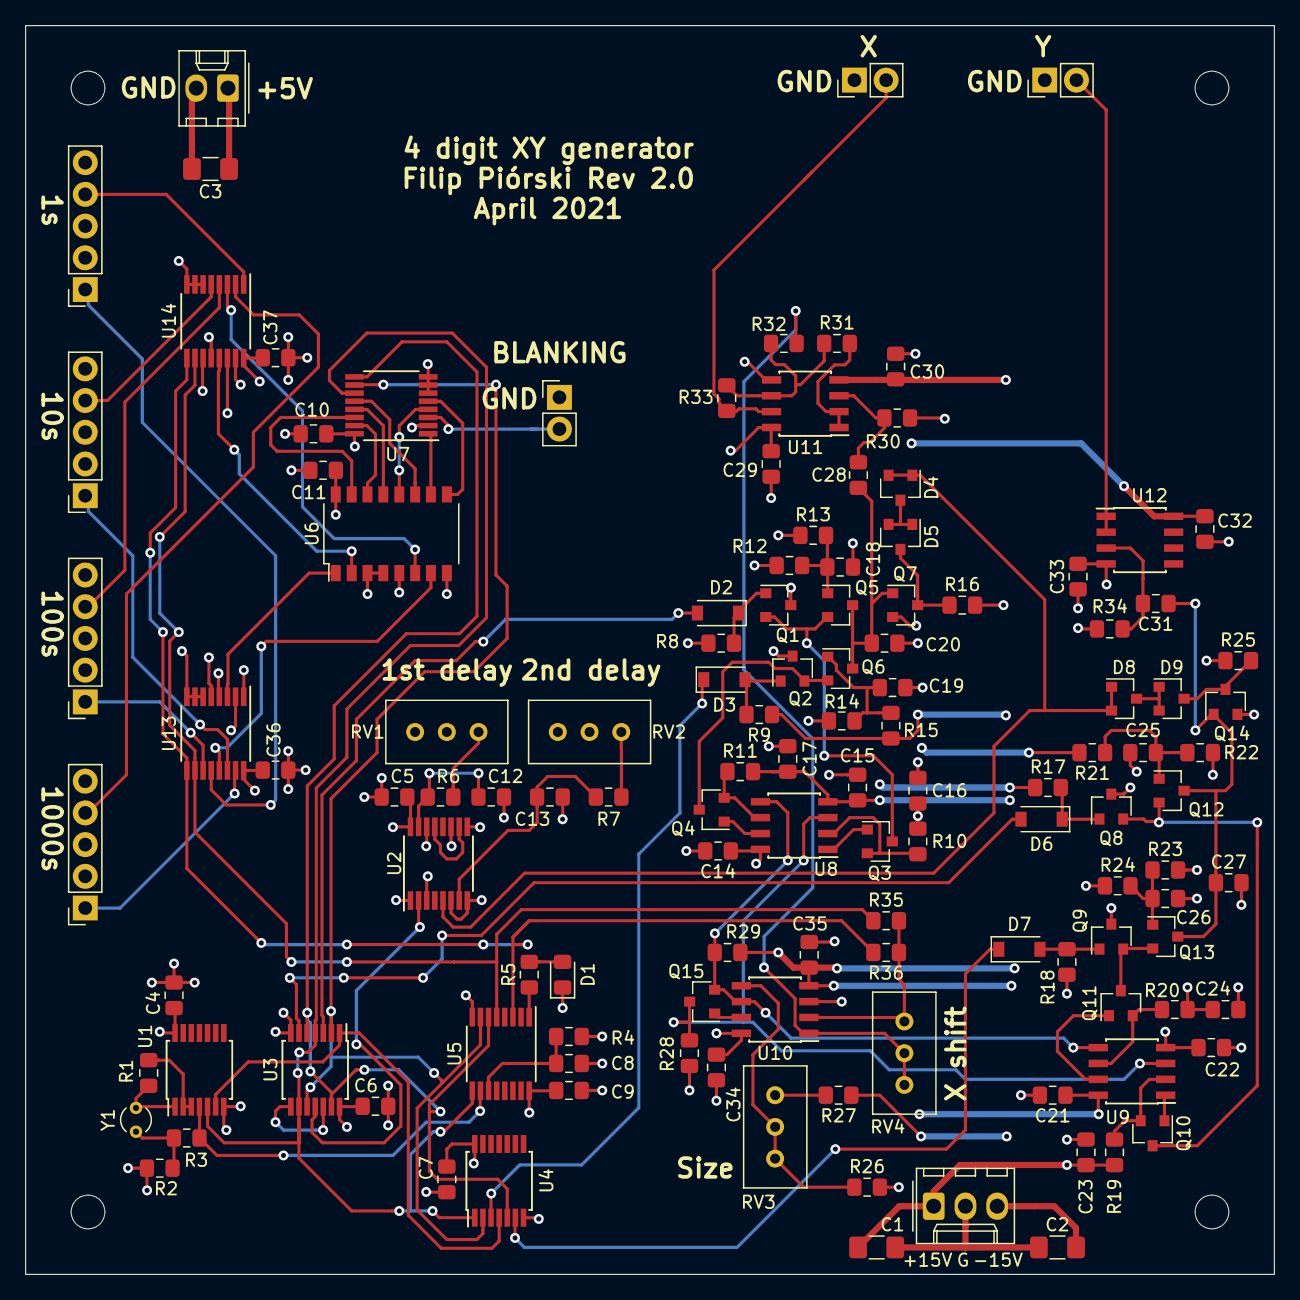
[picture p27: board XYgen.kicad_pcb from above]

Board: 4 copper layers, 100.0 x 100.0 mm, 129 parts (0 on the bottom side), 96 nets.
